TheWisator/RPII_DC_ePump/Submission/04_Drawings/01_Motor/Winding Layout.docx

## Winding Layout – Electric Motor RPII Pumps

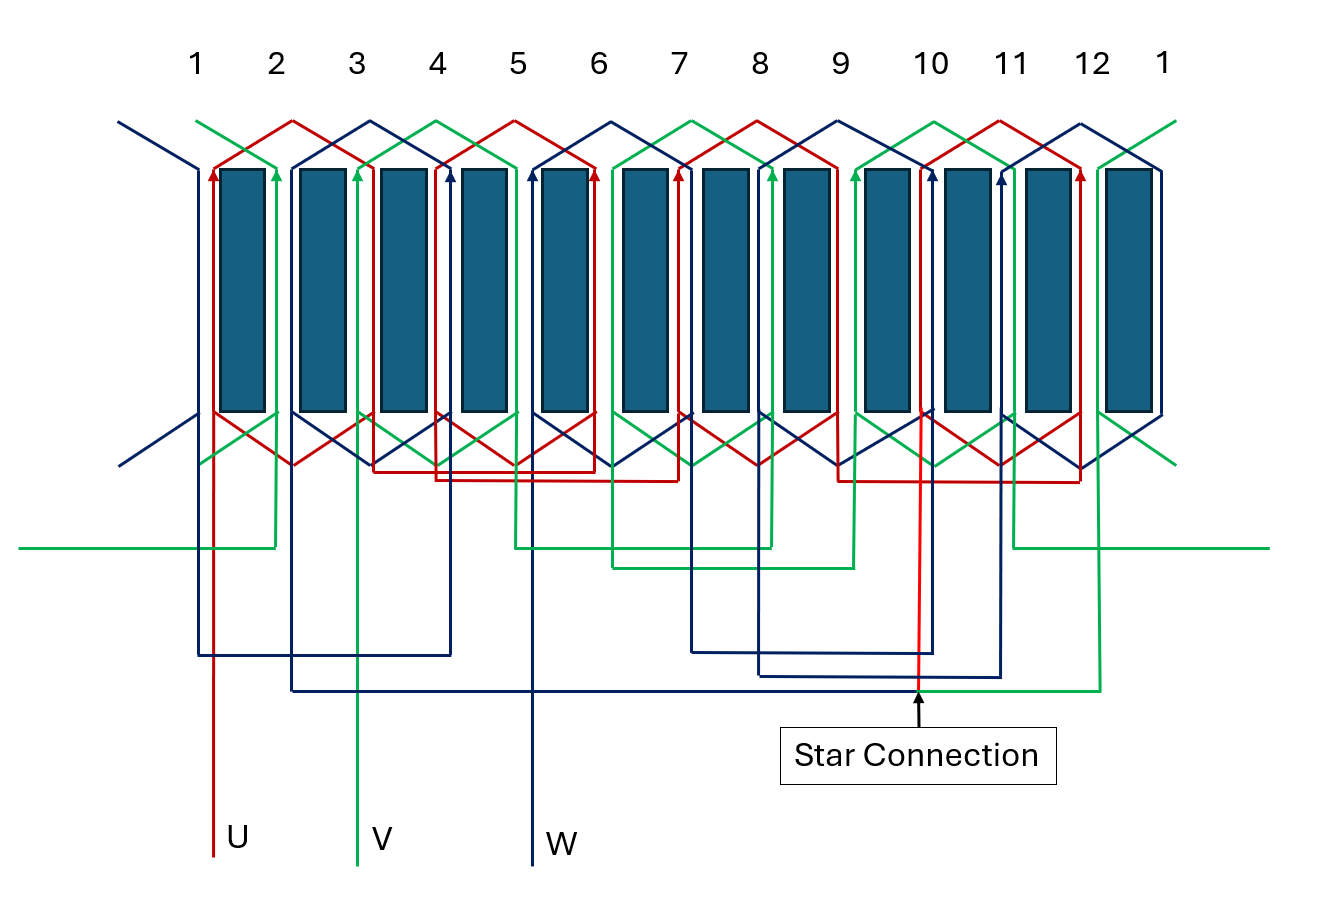
[picture p1: figure]

Winding parameters

Parameter | Value
Slots | 12
Phases | 3
Turns per Coil | 3
Wires at Hand | 14
Wire diameter (IEC-60317-13) [mm] | 0.75
Coil pitch | 2
Layers | 2
Parallel paths | 1
