TheWisator/RPII_DC_ePump/Submission/01_Skripts/02_Motor/FEM Studies/EM/T_over_n.pdf

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

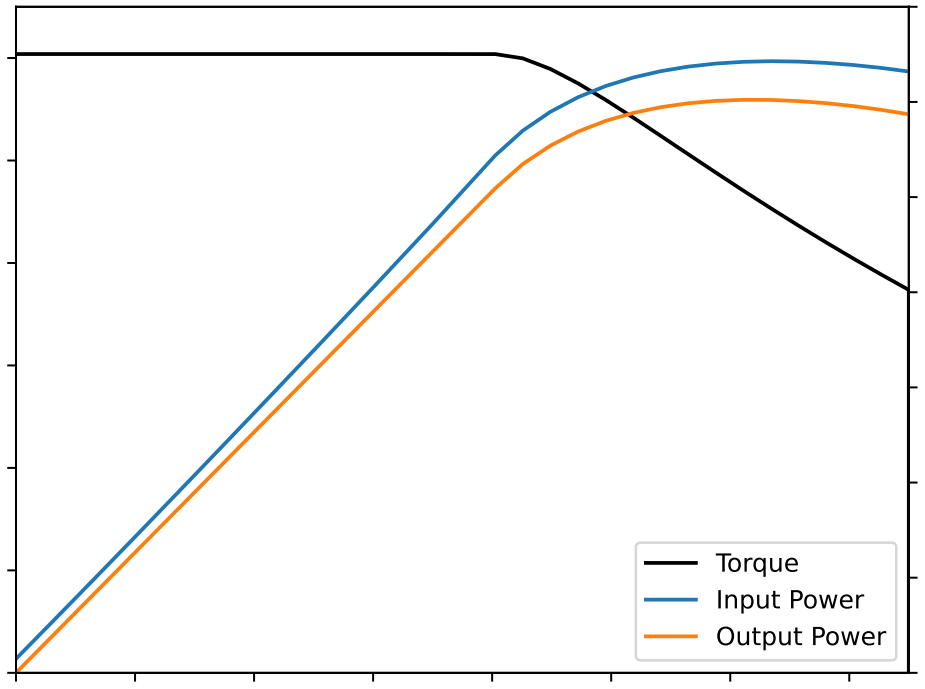
[picture p2: figure]
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
