TheWisator/RPII_DC_ePump/Submission/01_Skripts/02_Motor/FEM Studies/Structural/PEEK-30bar-0_3mm_pretension.png

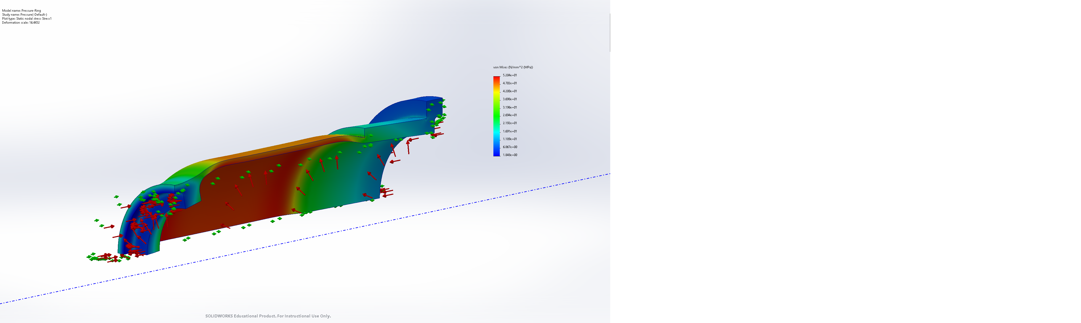
Submission/01_Skripts/02_Motor/FEM Studies/Structural/PEEK-30bar-0_3mm_pretension.png
