TheWisator/RPII_DC_ePump/Submission/02_CAD/Main-Housing.SLDPRT

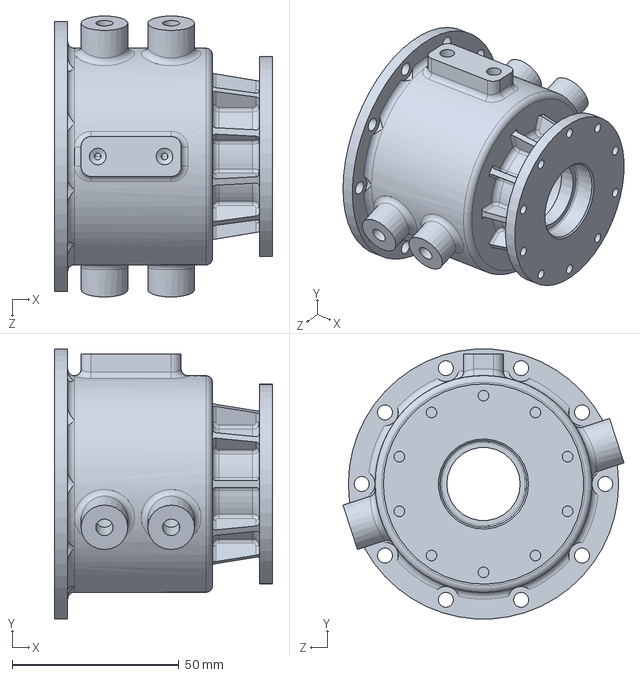
[picture p4: CAD file, 2024-03-20]
Submission/02_CAD/Main-Housing.SLDPRT
65.4 x 80.8 x 84.2 mm
