TheWisator/RPII_DC_ePump/Submission/02_CAD/MotorAssy_v1.SLDASM

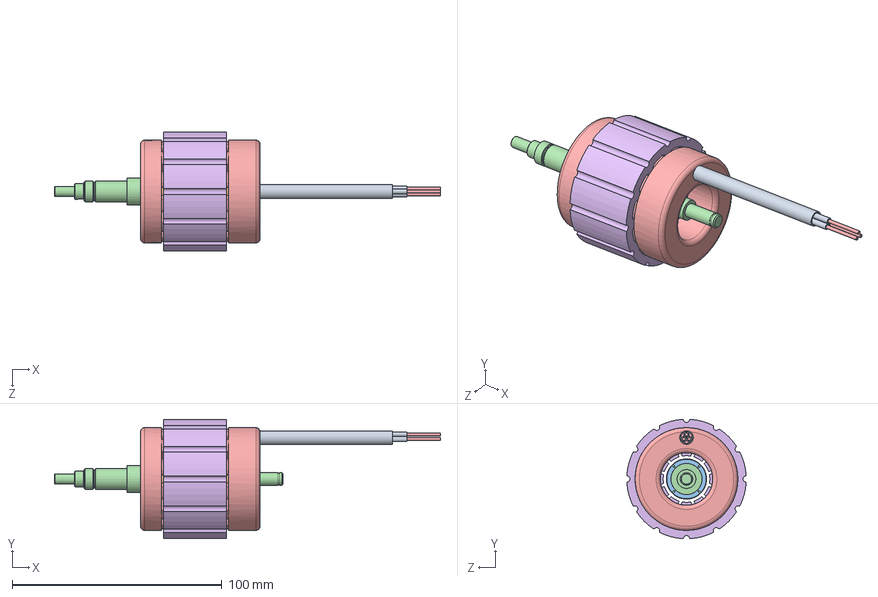
[picture p5: CAD file, 2024-03-20]
Submission/02_CAD/MotorAssy_v1.SLDASM
184.0 x 56.9 x 56.9 mm
Stator
Wind_Test_v1
Shaft
Permanent_Magnet_Arc x 4
CFRP-Rotor-Sleeve
Cable-Isolation
