TheWisator/RPII_DC_ePump/Submission/02_CAD/CI20-239-C-Ring.SLDPRT

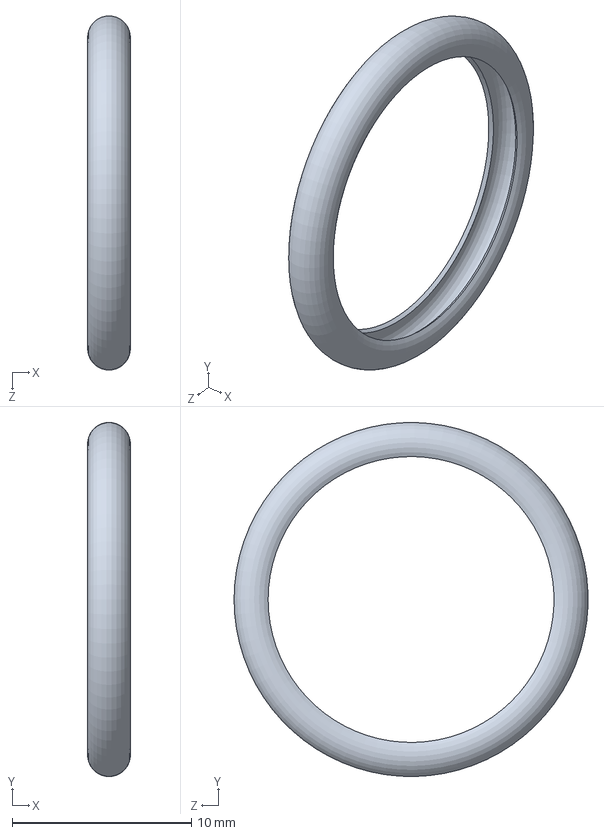
[picture p6: CAD file, 2024-03-20]
Submission/02_CAD/CI20-239-C-Ring.SLDPRT
2.39 x 19.7 x 19.7 mm
