TheWisator/RPII_DC_ePump/Submission/02_CAD/12x21x5-Ang_Hybrid_Ball_Bearing.SLDPRT

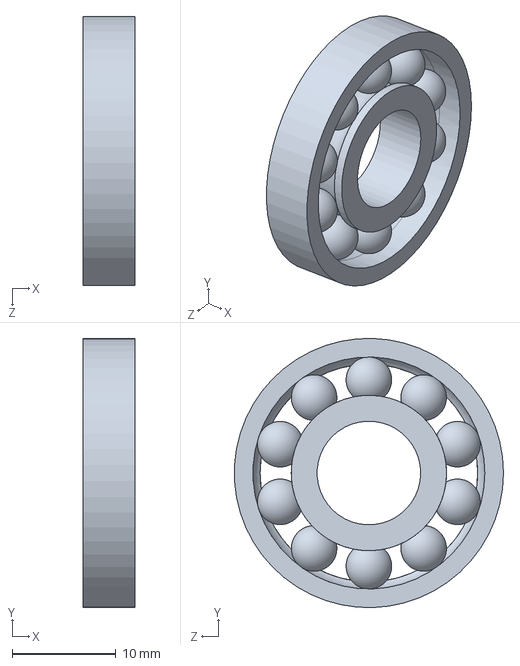
[picture p7: CAD file, 2024-03-20]
Submission/02_CAD/12x21x5-Ang_Hybrid_Ball_Bearing.SLDPRT
5.00 x 26.0 x 26.0 mm
