TheWisator/RPII_DC_ePump/Submission/02_CAD/Housing-Lid.SLDPRT

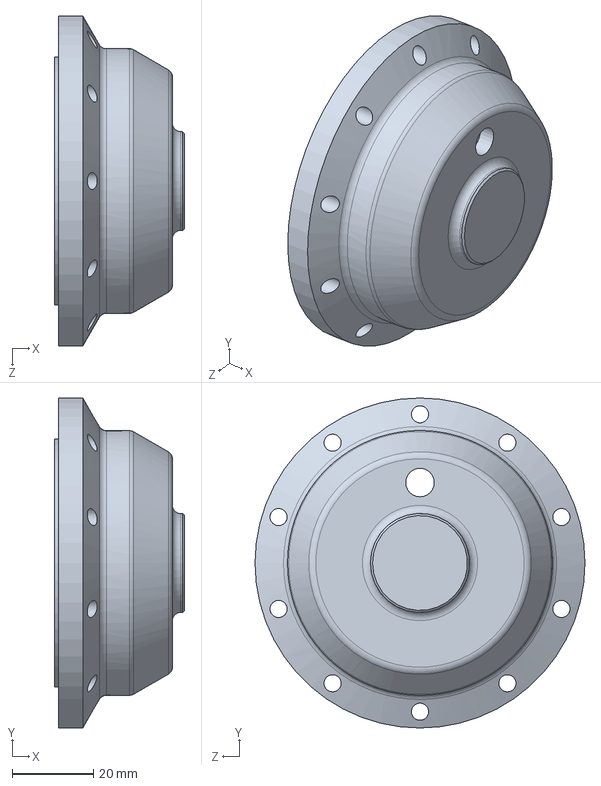
[picture p8: CAD file, 2024-03-20]
Submission/02_CAD/Housing-Lid.SLDPRT
32.0 x 81.0 x 81.0 mm
