TheWisator/RPII_DC_ePump/Submission/02_CAD/Rotor_Test_v1.SLDPRT

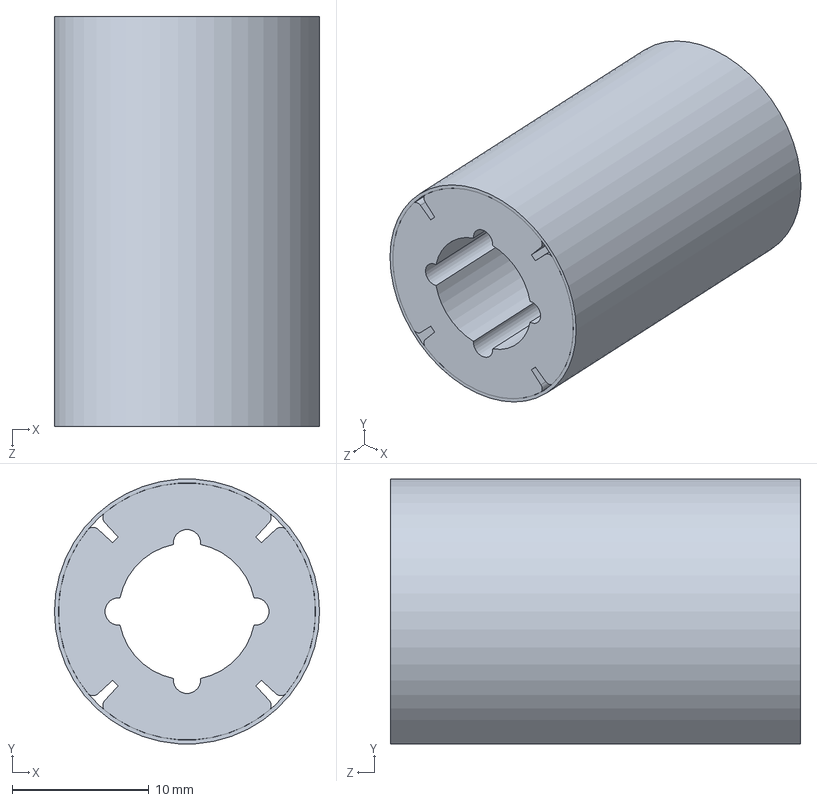
[picture p9: CAD file, 2024-03-20]
Submission/02_CAD/Rotor_Test_v1.SLDPRT
19.4 x 19.4 x 30.0 mm
