TheWisator/RPII_DC_ePump/Submission/02_CAD/Permanent_Magnet_Arc.SLDPRT

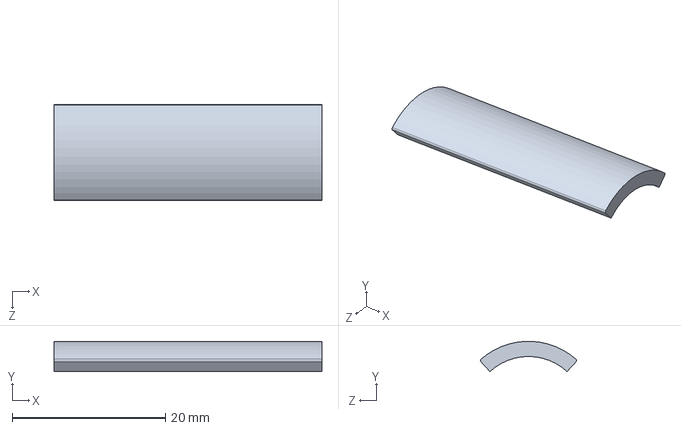
[picture p10: CAD file, 2024-03-20]
Submission/02_CAD/Permanent_Magnet_Arc.SLDPRT
35.0 x 3.94 x 12.5 mm
