TheWisator/RPII_DC_ePump/Submission/02_CAD/7x14x5-Hybrid_Ball_Bearing.SLDPRT

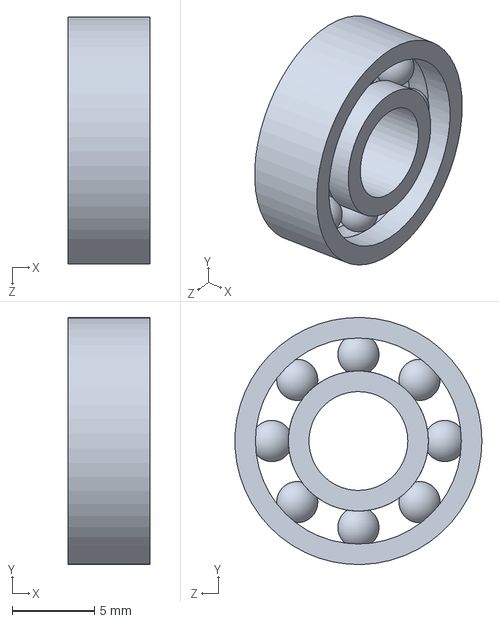
[picture p11: CAD file, 2024-03-20]
Submission/02_CAD/7x14x5-Hybrid_Ball_Bearing.SLDPRT
5.00 x 15.0 x 15.0 mm
