TheWisator/RPII_DC_ePump/Submission/02_CAD/Bearing-Ring.SLDPRT

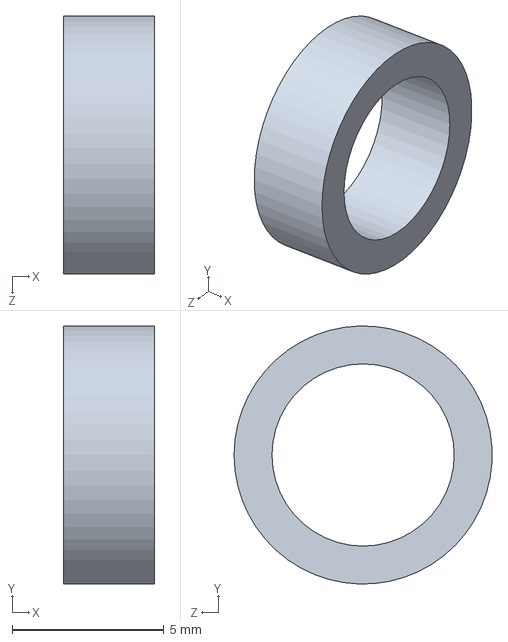
[picture p12: CAD file, 2024-03-20]
Submission/02_CAD/Bearing-Ring.SLDPRT
3.00 x 8.50 x 8.49 mm
