TheWisator/RPII_DC_ePump/Submission/02_CAD/CFRP-Rotor-Sleeve.SLDPRT

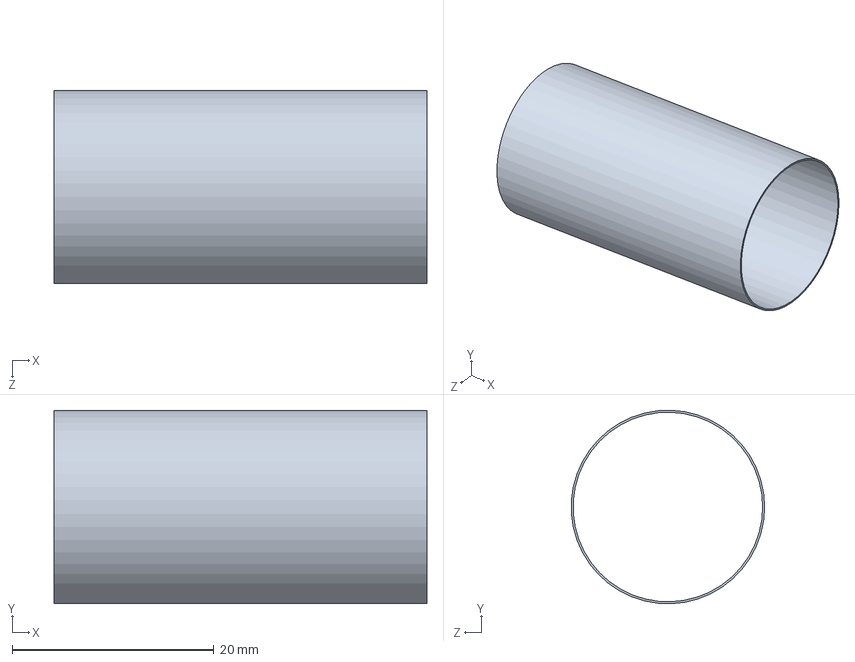
[picture p13: CAD file, 2024-03-20]
Submission/02_CAD/CFRP-Rotor-Sleeve.SLDPRT
37.0 x 19.2 x 19.2 mm
