TheWisator/RPII_DC_ePump/Submission/02_CAD/Impeller_LOX.SLDPRT

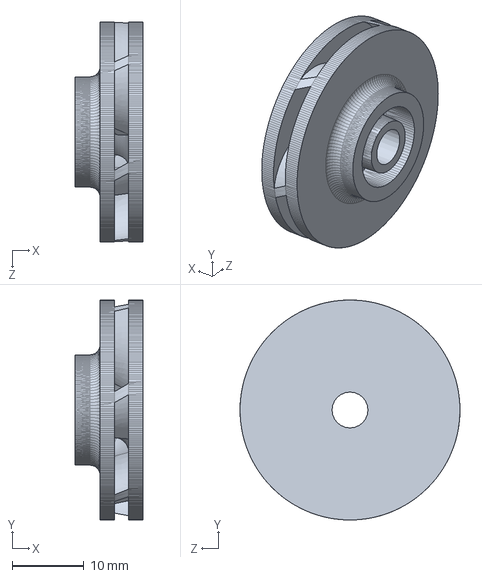
[picture p14: CAD file, 2024-03-20]
Submission/02_CAD/Impeller_LOX.SLDPRT
9.50 x 30.7 x 30.7 mm
