TheWisator/RPII_DC_ePump/Submission/02_CAD/Pressure-Ring.SLDPRT

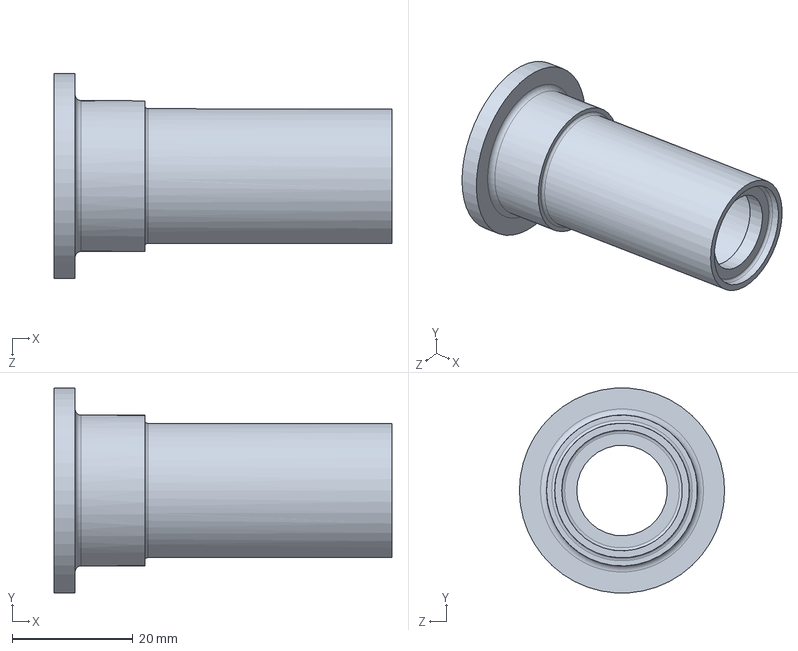
[picture p15: CAD file, 2024-03-20]
Submission/02_CAD/Pressure-Ring.SLDPRT
56.0 x 33.9 x 34.0 mm
