TheWisator/RPII_DC_ePump/Submission/02_CAD/RPDC_Diffuser_Pump_Volute_Casing_LOX.SLDPRT

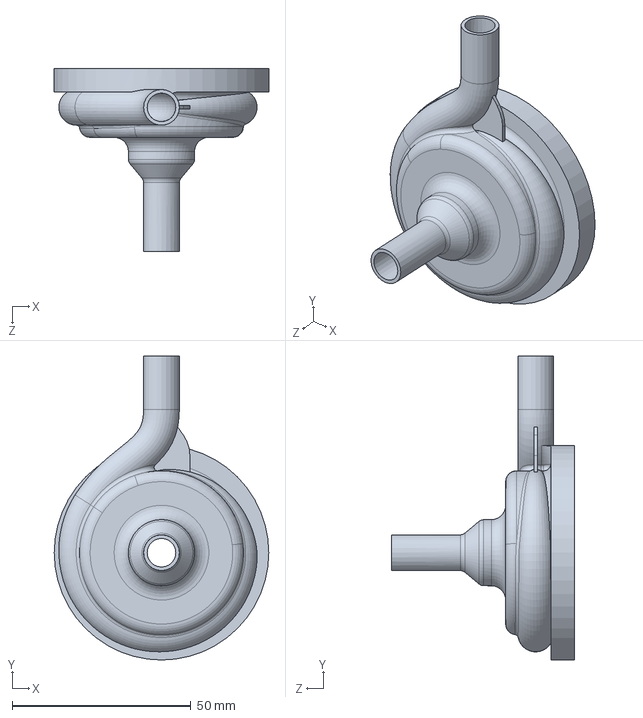
[picture p16: CAD file, 2024-03-20]
Submission/02_CAD/RPDC_Diffuser_Pump_Volute_Casing_LOX.SLDPRT
60.0 x 85.0 x 51.2 mm
