TheWisator/RPII_DC_ePump/Submission/02_CAD/CI25-239-C-Ring.SLDPRT

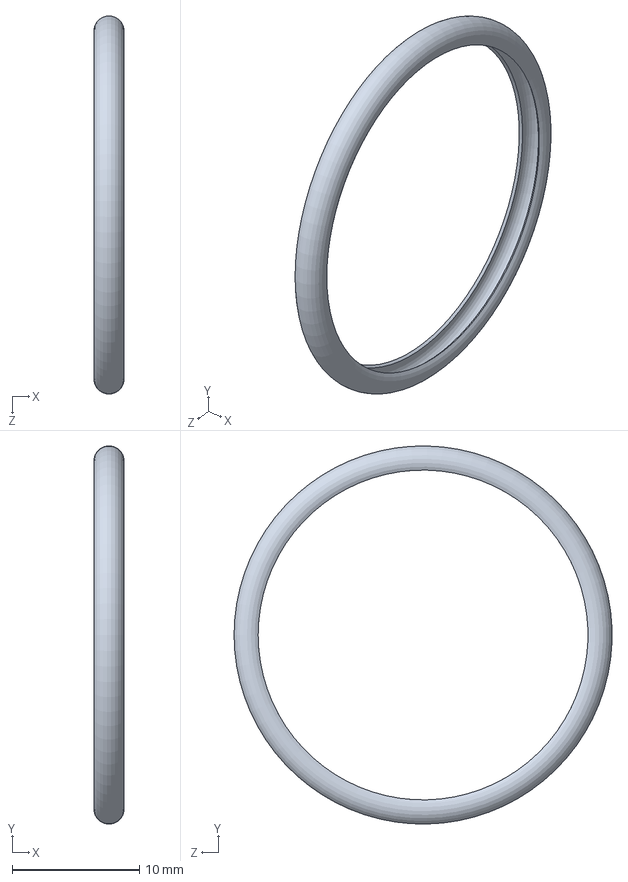
[picture p17: CAD file, 2024-03-20]
Submission/02_CAD/CI25-239-C-Ring.SLDPRT
2.37 x 29.7 x 29.7 mm
