TheWisator/RPII_DC_ePump/Submission/02_CAD/Diffuser_LOX.SLDPRT

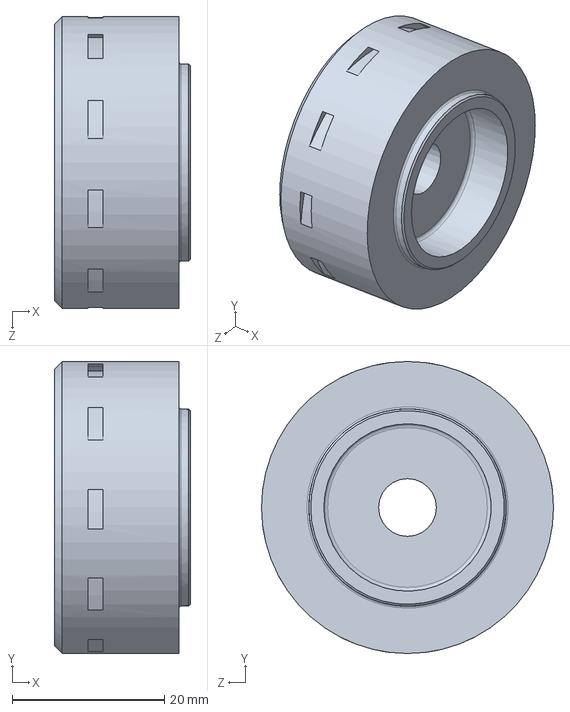
[picture p18: CAD file, 2024-03-20]
Submission/02_CAD/Diffuser_LOX.SLDPRT
17.9 x 38.4 x 38.4 mm
