TheWisator/RPII_DC_ePump/Submission/02_CAD/Tension-Ring.SLDPRT

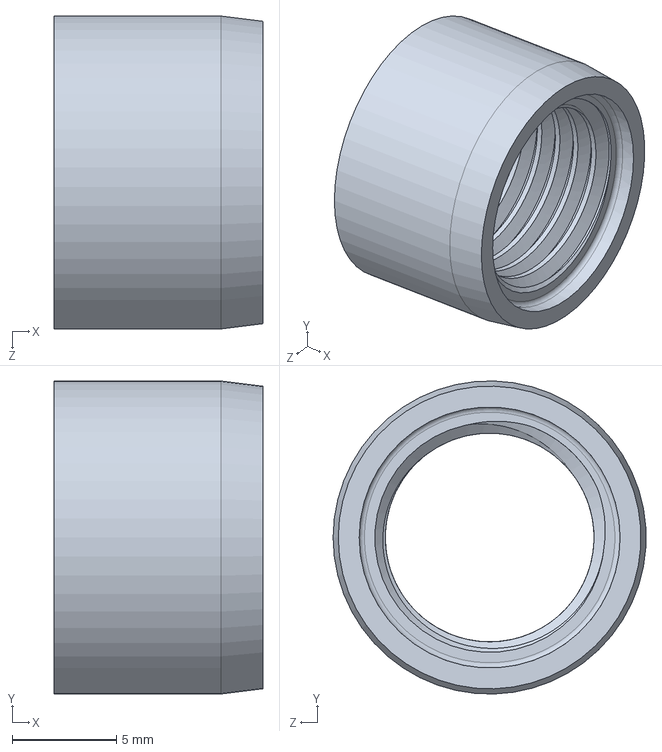
[picture p19: CAD file, 2024-03-20]
Submission/02_CAD/Tension-Ring.SLDPRT
10.0 x 15.0 x 15.0 mm
