TheWisator/RPII_DC_ePump/Submission/02_CAD/Stat_Test_v1.SLDPRT

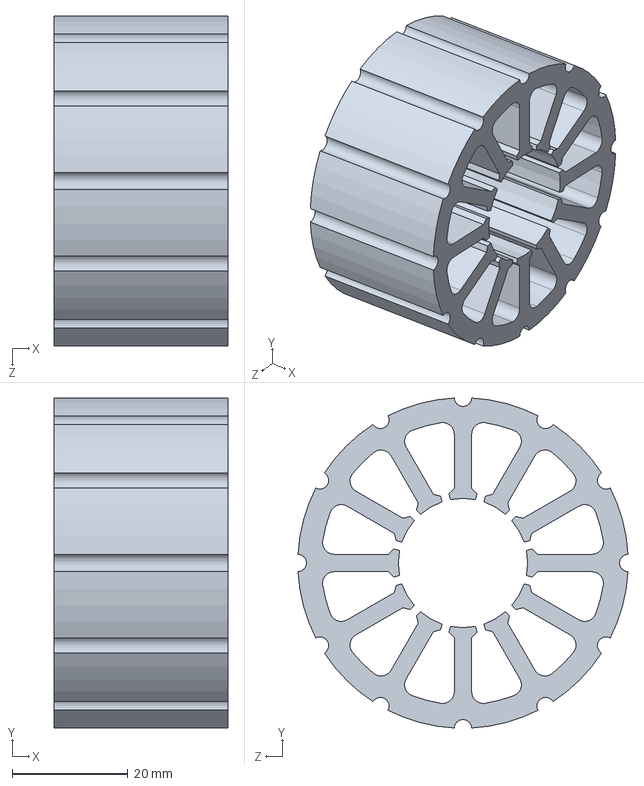
[picture p20: CAD file, 2024-03-20]
Submission/02_CAD/Stat_Test_v1.SLDPRT
30.0 x 56.9 x 56.9 mm
