TheWisator/RPII_DC_ePump/Submission/02_CAD/Wind_Test_v1.SLDPRT

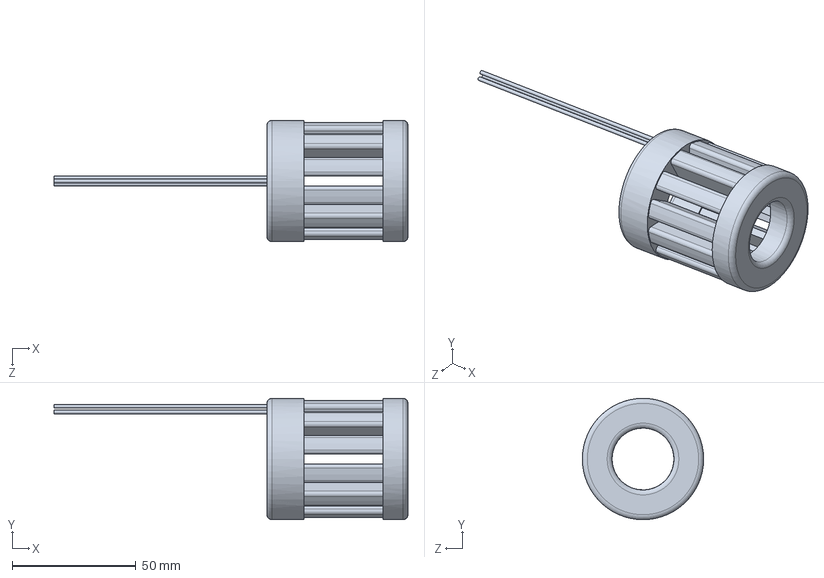
[picture p21: CAD file, 2024-03-20]
Submission/02_CAD/Wind_Test_v1.SLDPRT
143.0 x 49.0 x 49.0 mm
