TheWisator/RPII_DC_ePump/Submission/02_CAD/Shaft.SLDPRT

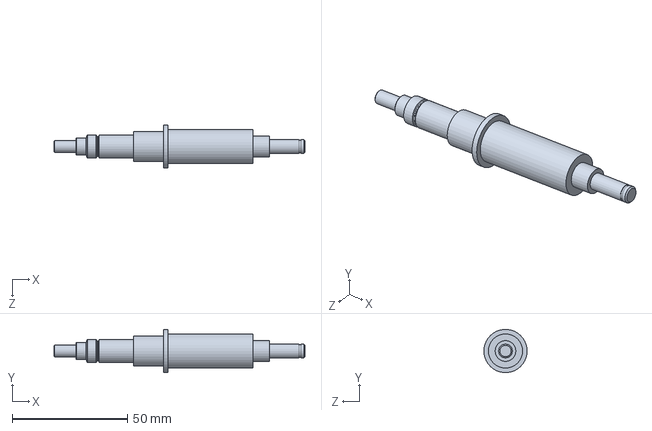
[picture p22: CAD file, 2024-03-20]
Submission/02_CAD/Shaft.SLDPRT
109.0 x 18.7 x 18.8 mm
