TheWisator/RPII_DC_ePump/Submission/02_CAD/Stator_Test_v1.SLDPRT

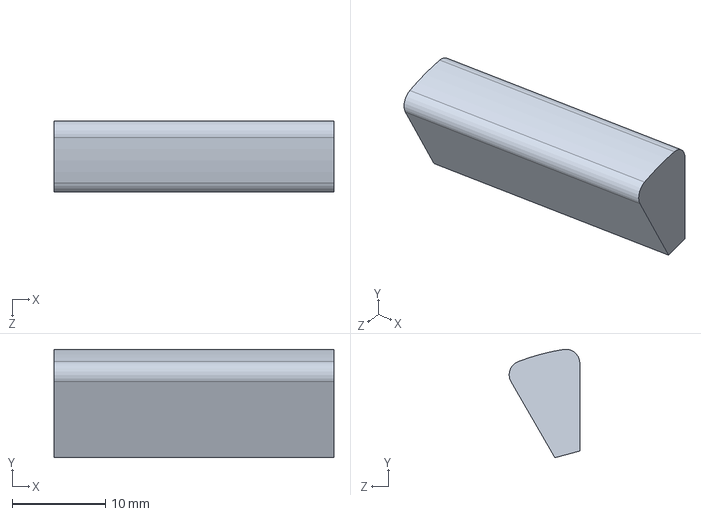
[picture p23: CAD file, 2024-03-20]
Submission/02_CAD/Stator_Test_v1.SLDPRT
30.0 x 11.6 x 7.58 mm
