TheWisator/RPII_DC_ePump/Submission/02_CAD/Controller_HBCi10063.STEP

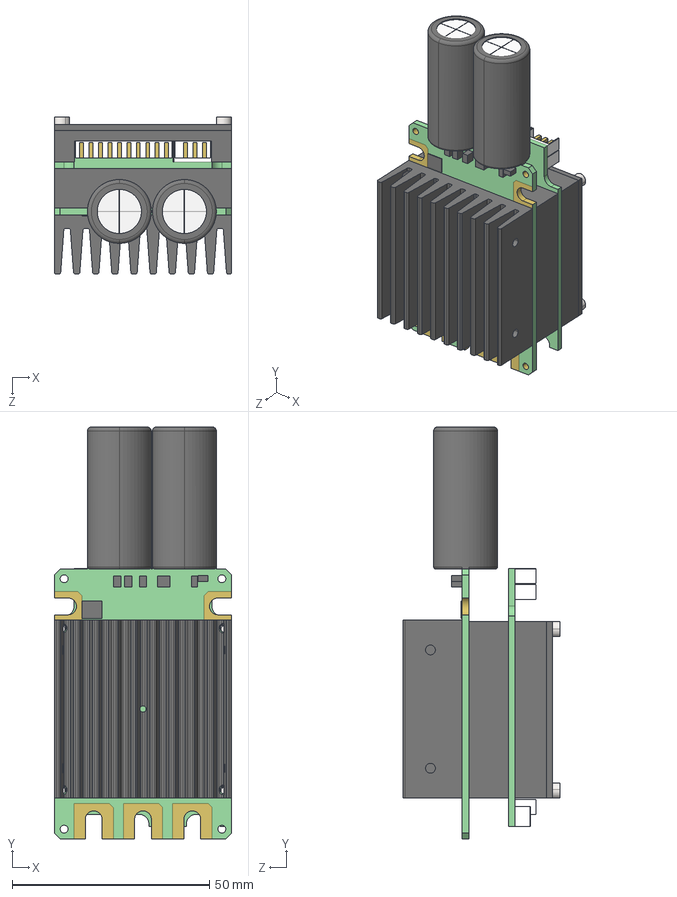
[picture p24: CAD file, 2024-03-20]
Submission/02_CAD/Controller_HBCi10063.STEP
45.0 x 104.5 x 39.9 mm
main_board
Cover_buttom
Cover_top
Top cover
Cooler
Control_board
ISO 4762 M2 x 20 - 20N_ISO 4762 M2 x 20 - 20N x 4
