TheWisator/RPII_DC_ePump/Submission/02_CAD/Cable-Isolation.SLDPRT

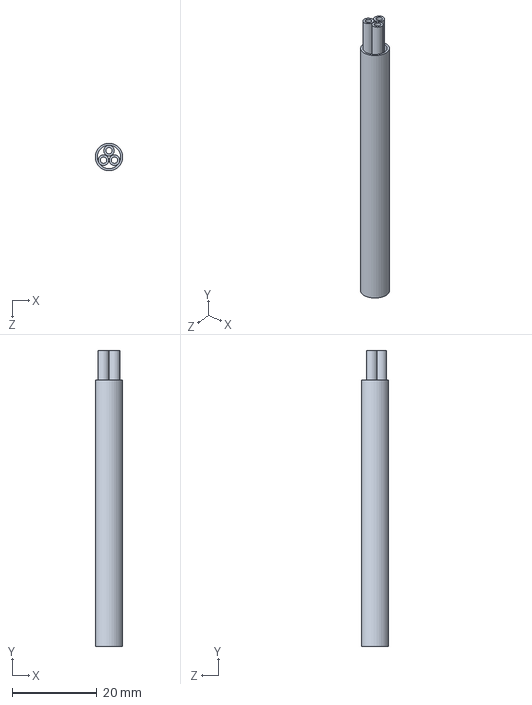
[picture p25: CAD file, 2024-03-20]
Submission/02_CAD/Cable-Isolation.SLDPRT
6.47 x 70.0 x 6.50 mm
