TheWisator/RPII_DC_ePump/Submission/02_CAD/Cooling-Adapter.SLDPRT

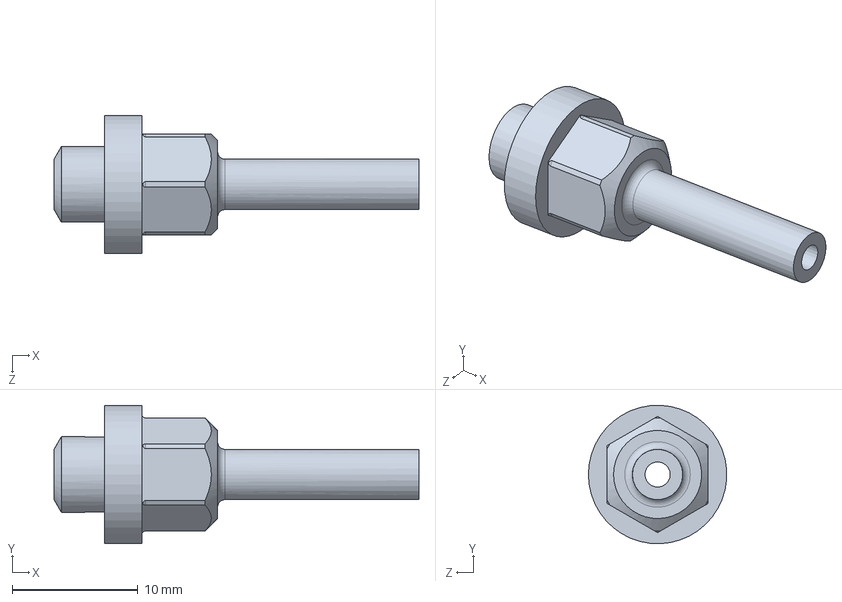
[picture p26: CAD file, 2024-03-20]
Submission/02_CAD/Cooling-Adapter.SLDPRT
29.0 x 11.0 x 11.0 mm
