TheWisator/RPII_DC_ePump/Submission/02_CAD/Battery.stp

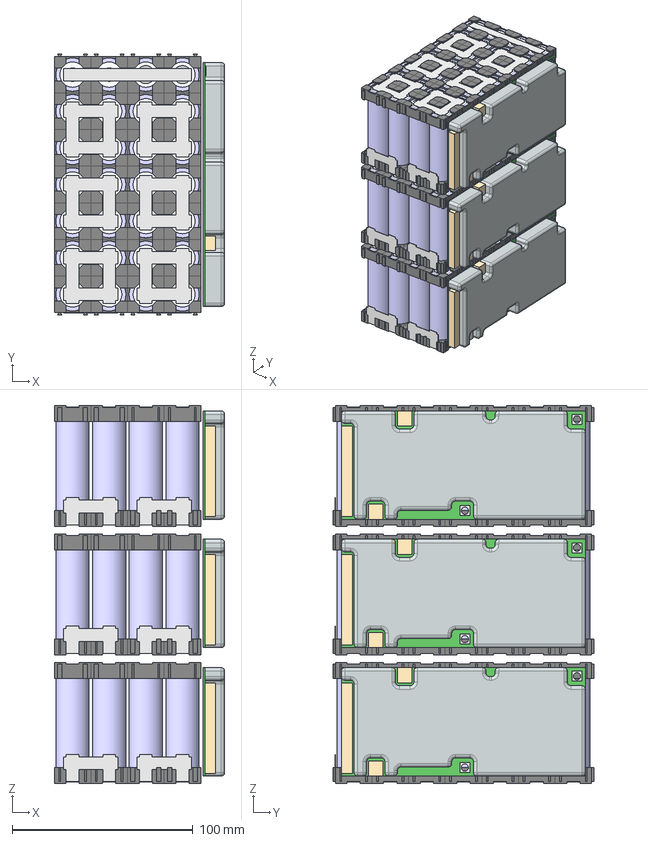
[picture p27: CAD file, 2024-03-20]
Submission/02_CAD/Battery.stp
94.3 x 144.3 x 209.0 mm
spacer x 336
BMS x 3
nickel-grid x 36
nickel-strip-long x 3
nickel-grid-half x 12
