TheWisator/RPII_DC_ePump/Submission/02_CAD/Shaft-Model-Reduced.SLDASM

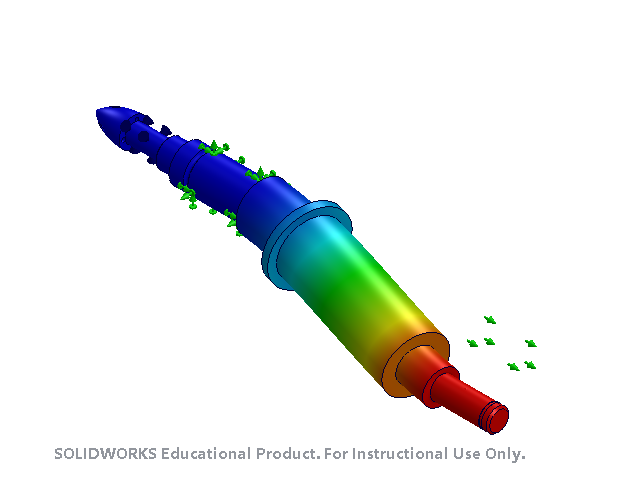
[picture p28: CAD file, 2024-03-20]
Submission/02_CAD/Shaft-Model-Reduced.SLDASM
Impeller-Nut
Shaft
