TheWisator/RPII_DC_ePump/(list of files, cad)

Other CAD files:
Submission/02_CAD/Stator.SLDPRT
Submission/02_CAD/65363000-KM 0-M10 x 0_75.stp
Submission/02_CAD/65399530-MB 0.stp
Submission/02_CAD/Controller_HBCi10063.SLDPRT
Submission/02_CAD/DIN933-M3.SLDPRT
Submission/02_CAD/Housing-Lid.SLDDRW
Submission/02_CAD/Impeller-Nut.SLDPRT
Submission/02_CAD/Main-Housing.SLDDRW
Submission/02_CAD/MotorAssy_v1.SLDDRW
Submission/02_CAD/Permanent_Magnet_Arc.SLDDRW
Submission/02_CAD/Pressure-Ring.SLDDRW
Submission/02_CAD/Shaft.SLDDRW
Submission/02_CAD/Stator.SLDDRW
