TheWisator/RPII_DC_ePump/Submission/01_Skripts/02_Motor/FEM Studies/EM/Optim_Results_1.csv

OD | L | TM | HS | WT | WIN | Mass | MR | MS | TRQ | P | EFF | VOL
55 | 30 | 1.5 | 12.5 | 3 | 10 | 0.6473972 | 0.0494029 | 0.5979943 | 0.5203448 | 2179.6153 | 93.3983 | 39.102341
60.272 | 33.976 | 1.9840001 | 11.746876 | 3.27421 | 8 | 0.7874552 | 0.0556832 | 0.7317721 | 0.5246581 | 2197.6826 | 94.966658 | 45.374363
51.9272 | 34.8976 | 1.1984 | 13.774428 | 3.3673511 | 8 | 0.5611984 | 0.0576477 | 0.5035507 | 0.3166259 | 1326.2796 | 81.56722 | 33.170415
59.6032 | 34.7056 | 1.0704 | 13.728264 | 3.4767476 | 10 | 0.8124774 | 0.0574082 | 0.7550692 | 0.5198549 | 2177.5629 | 94.085553 | 41.35781
60.3784 | 28.5872 | 1.9248 | 12.997873 | 2.7388399 | 8 | 0.6538836 | 0.0468783 | 0.6070054 | 0.4330382 | 1813.9063 | 93.636943 | 38.178795
53.1736 | 34.6288 | 1.2192 | 11.307465 | 3.4865587 | 11 | 0.6444199 | 0.0484391 | 0.5959808 | 0.3573352 | 1496.8023 | 92.800865 | 35.312147
52.2768 | 34.3344 | 1.2896 | 11.033568 | 2.8099586 | 8 | 0.6085147 | 0.0566632 | 0.5518515 | 0.446309 | 1869.4946 | 93.4249 | 40.350915
60.4848 | 31.1984 | 1.8656001 | 11.252327 | 3.4090106 | 11 | 0.6484457 | 0.0559315 | 0.5925142 | 0.4161319 | 1743.0894 | 94.136478 | 38.348796
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
