TheWisator/RPII_DC_ePump/Submission/04_Drawings/01_Motor/Motor-Assembly.pdf

E E

F F

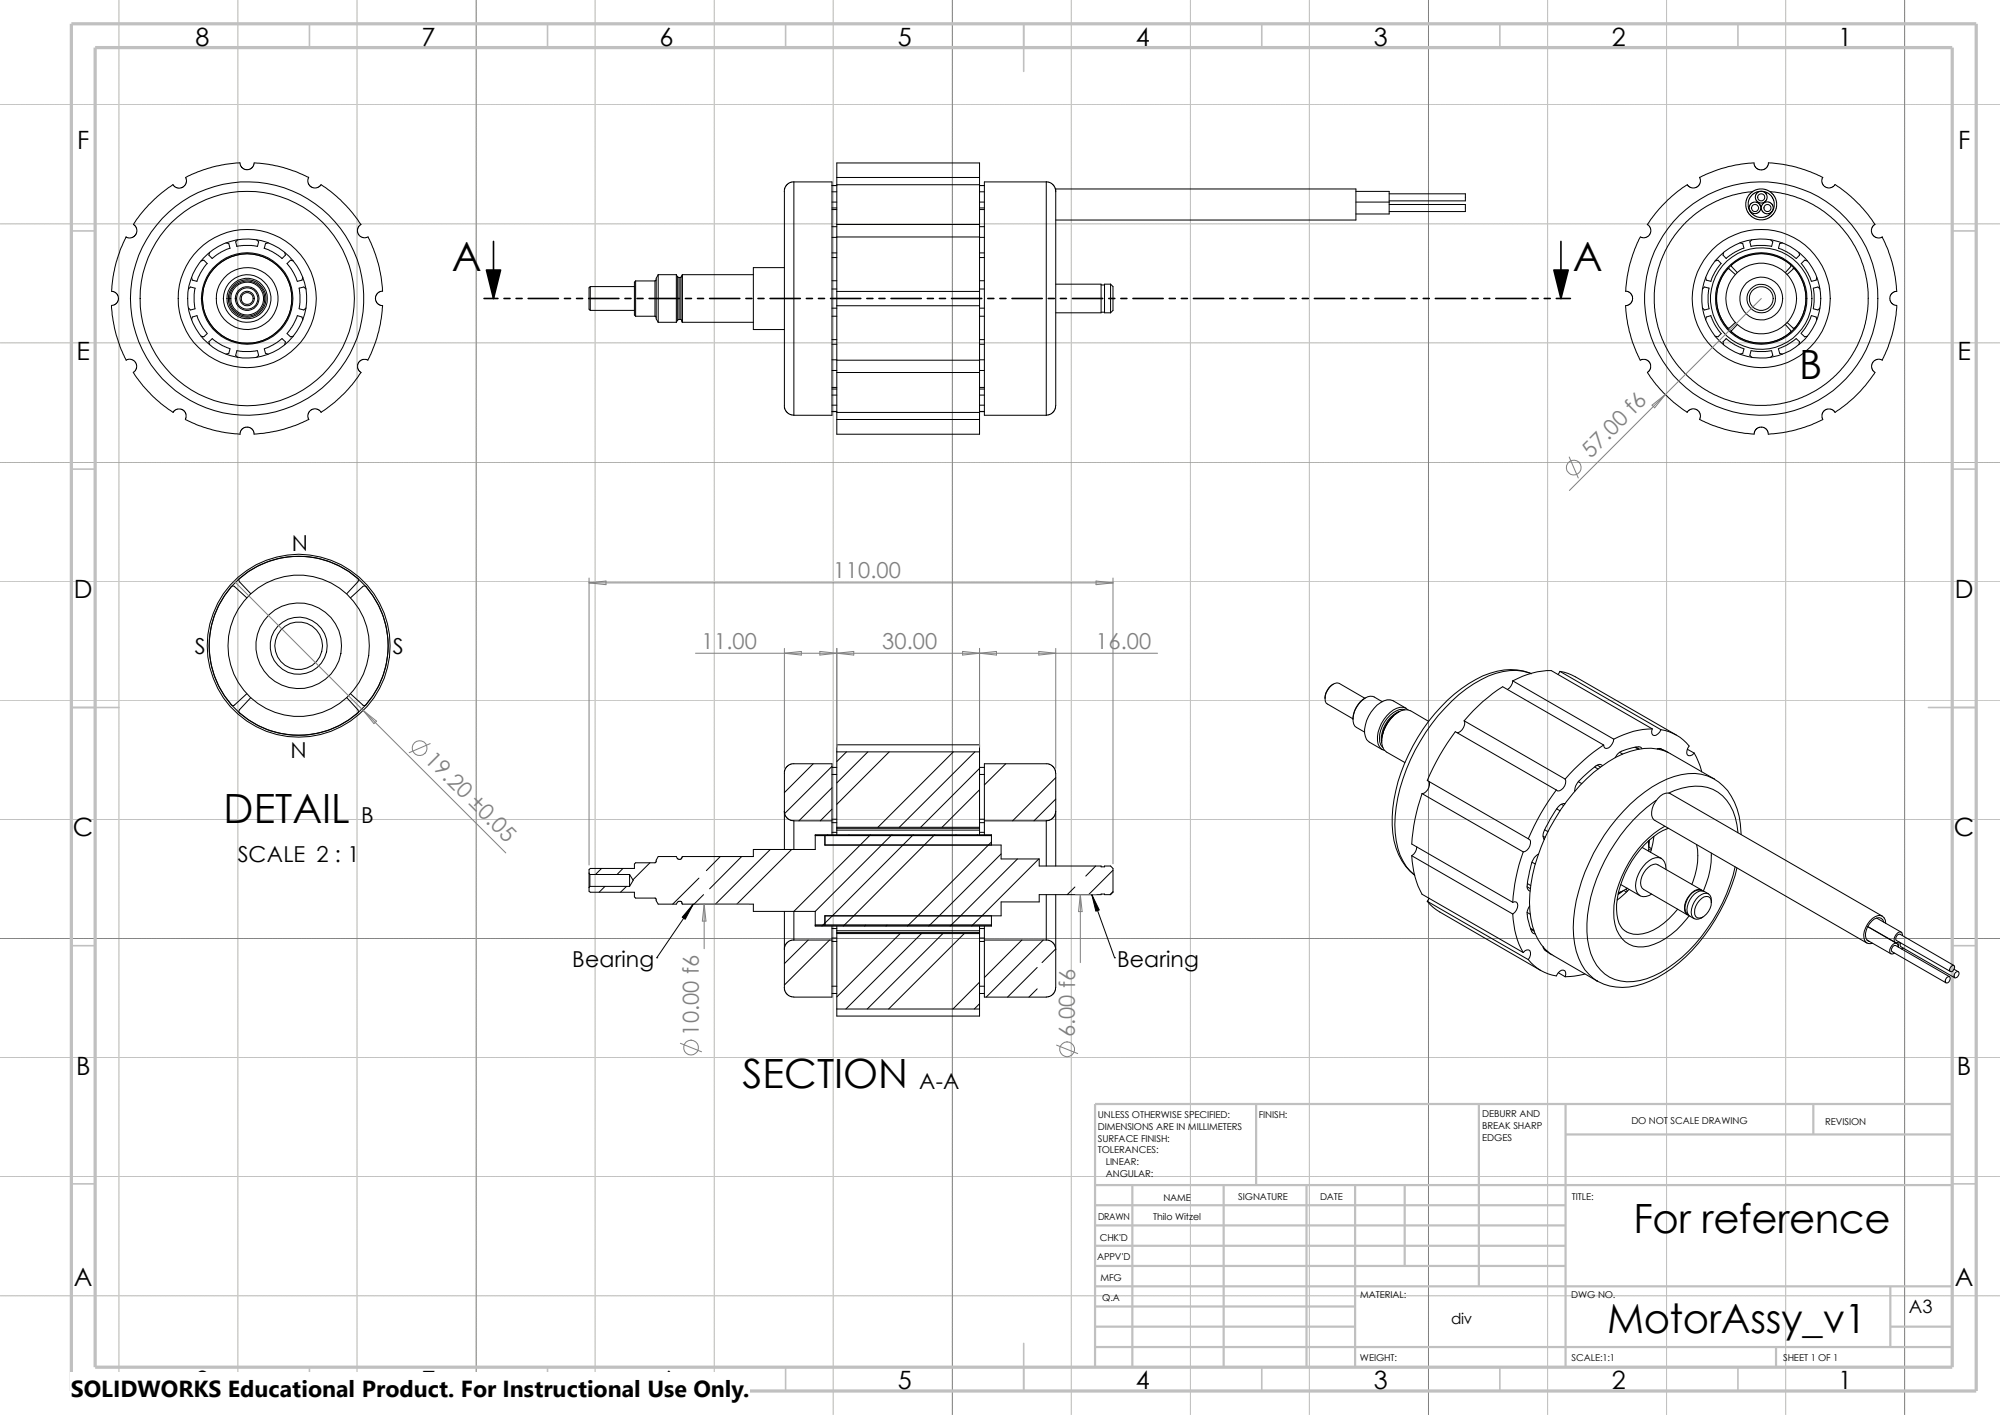
[picture p29: page 1]
FINISH:; EDGES; DO NOT SCALE DRAWING; REVISION; DEBURR AND BREAK SHARP; N DETAIL B; SCALE; SECTION A-A; Bearing

UNLESS OTHERWISE SPECIFIED:
DIMENSIONS ARE IN MILLIMETERS
SURFACE FINISH:
TOLERANCES:
LINEAR:
ANGULAR:

NAME | SIGNATURE | DATE | | | | TITLE: For reference

DRAWN | Thilo Witzel
CHK'D
APPV'D
Q.A | | | | MATERIAL: | div | DWG NO. MotorAssy_v1 | | A3

MFG

WEIGHT: | | SCALE:1:1 | | SHEET 1 OF 1

SOLIDWORKS Educational Product. For Instructional Use Only.
