TheWisator/RPII_DC_ePump/Submission/04_Drawings/LOX_Pump_Drawing.pdf

E E

F F

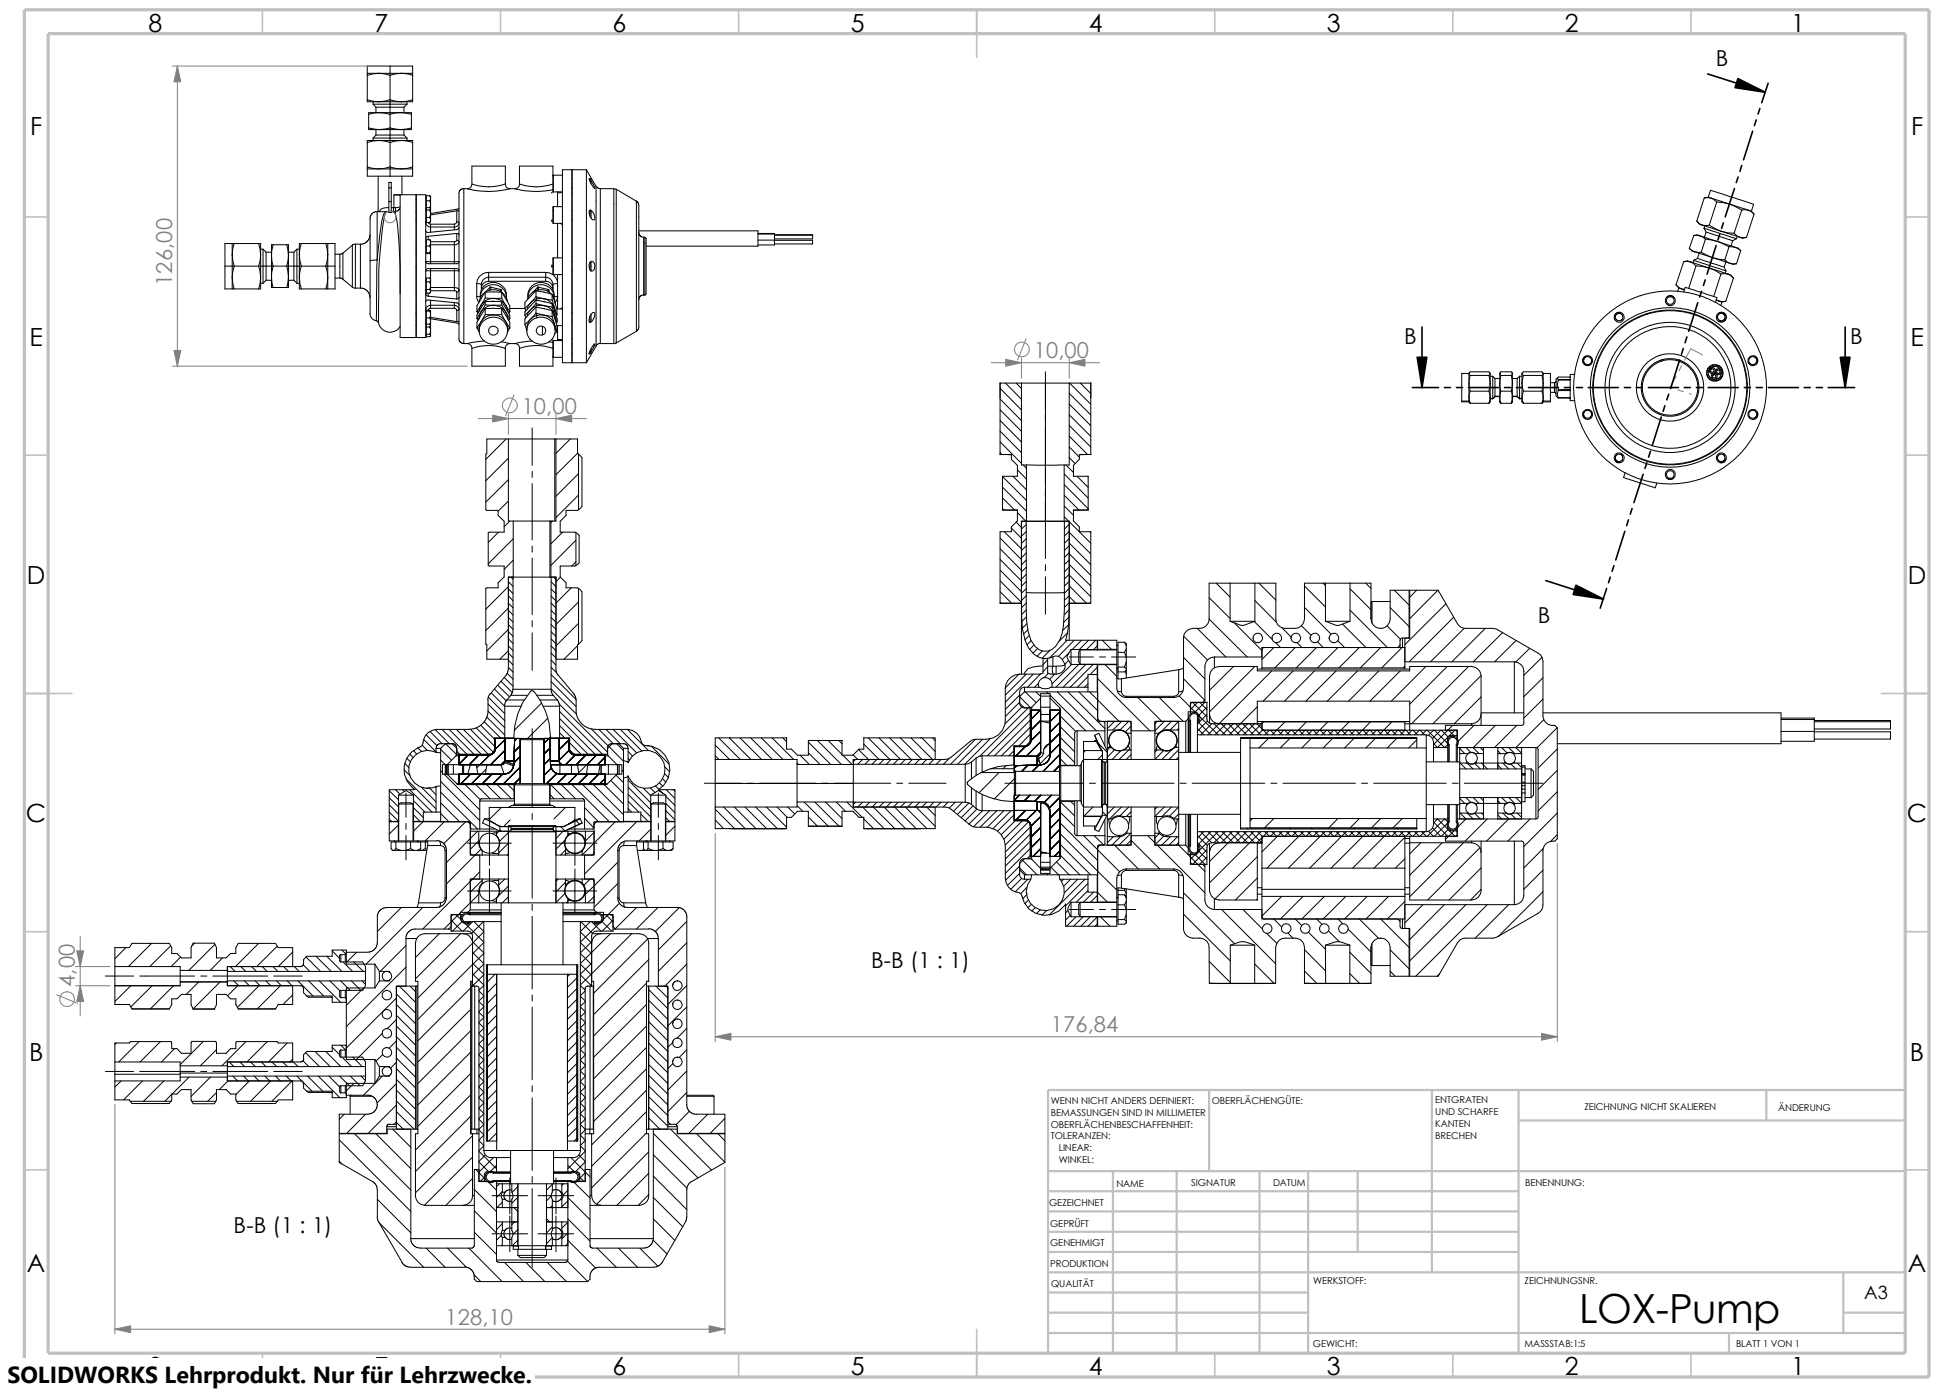
[picture p30: page 1]
GEWICHT:; MASSSTAB:1:5; BLATT 1 VON 1; BENENNUNG:; ZEICHNUNG NICHT SKALIEREN; ÄNDERUNG; DATUM; OBERFLÄCHENGÜTE:; KANTEN; UND SCHARFE; NAME; ENTGRATEN; SIGNATUR; BRECHEN; GEZEICHNET 126,00

WENN NICHT ANDERS DEFINIERT:
BEMASSUNGEN SIND IN MILLIMETER
OBERFLÄCHENBESCHAFFENHEIT:
TOLERANZEN:
LINEAR:
WINKEL:

GEPRÜFT
GENEHMIGT
QUALITÄT | WERKSTOFF: | ZEICHNUNGSNR. LOX-Pump | A3

PRODUKTION

SOLIDWORKS Lehrprodukt. Nur für Lehrzwecke.
