TheWisator/RPII_DC_ePump/Submission/04_Drawings/01_Motor/Stator.pdf

E E

F F

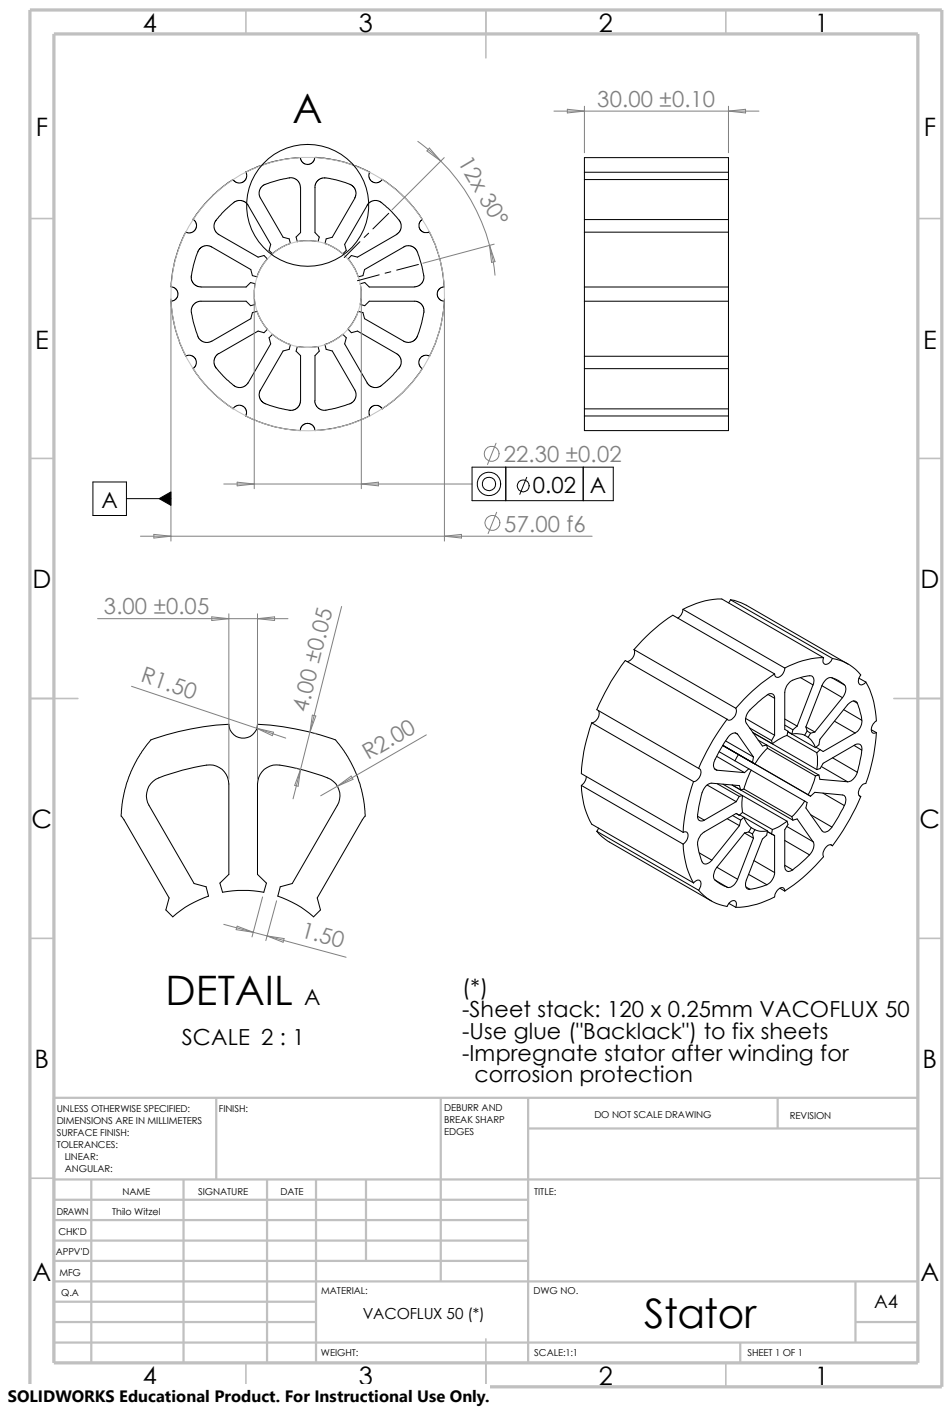
[picture p31: page 1]
VACOFLUX 50 (*); WEIGHT:; SCALE:1:1; SHEET 1 OF 1; DWG NO.; MFG; FINISH:; EDGES; MATERIAL:; DO NOT SCALE DRAWING; REVISION; DEBURR AND BREAK SHARP; Stator; DETAIL A; SCALE 2 : 1

-Sheet stack: 120 x 0.25mm VACOFLUX 50
-Use glue ("Backlack") to fix sheets
-Impregnate stator after winding for
corrosion protection

UNLESS OTHERWISE SPECIFIED:
DIMENSIONS ARE IN MILLIMETERS
SURFACE FINISH:
TOLERANCES:
LINEAR:
ANGULAR:

NAME | SIGNATURE | DATE | TITLE:

DRAWN | Thilo Witzel
CHK'D
APPV'D

SOLIDWORKS Educational Product. For Instructional Use Only.
