TheWisator/RPII_DC_ePump/Submission/04_Drawings/01_Motor/Magnet.pdf

E E

F F

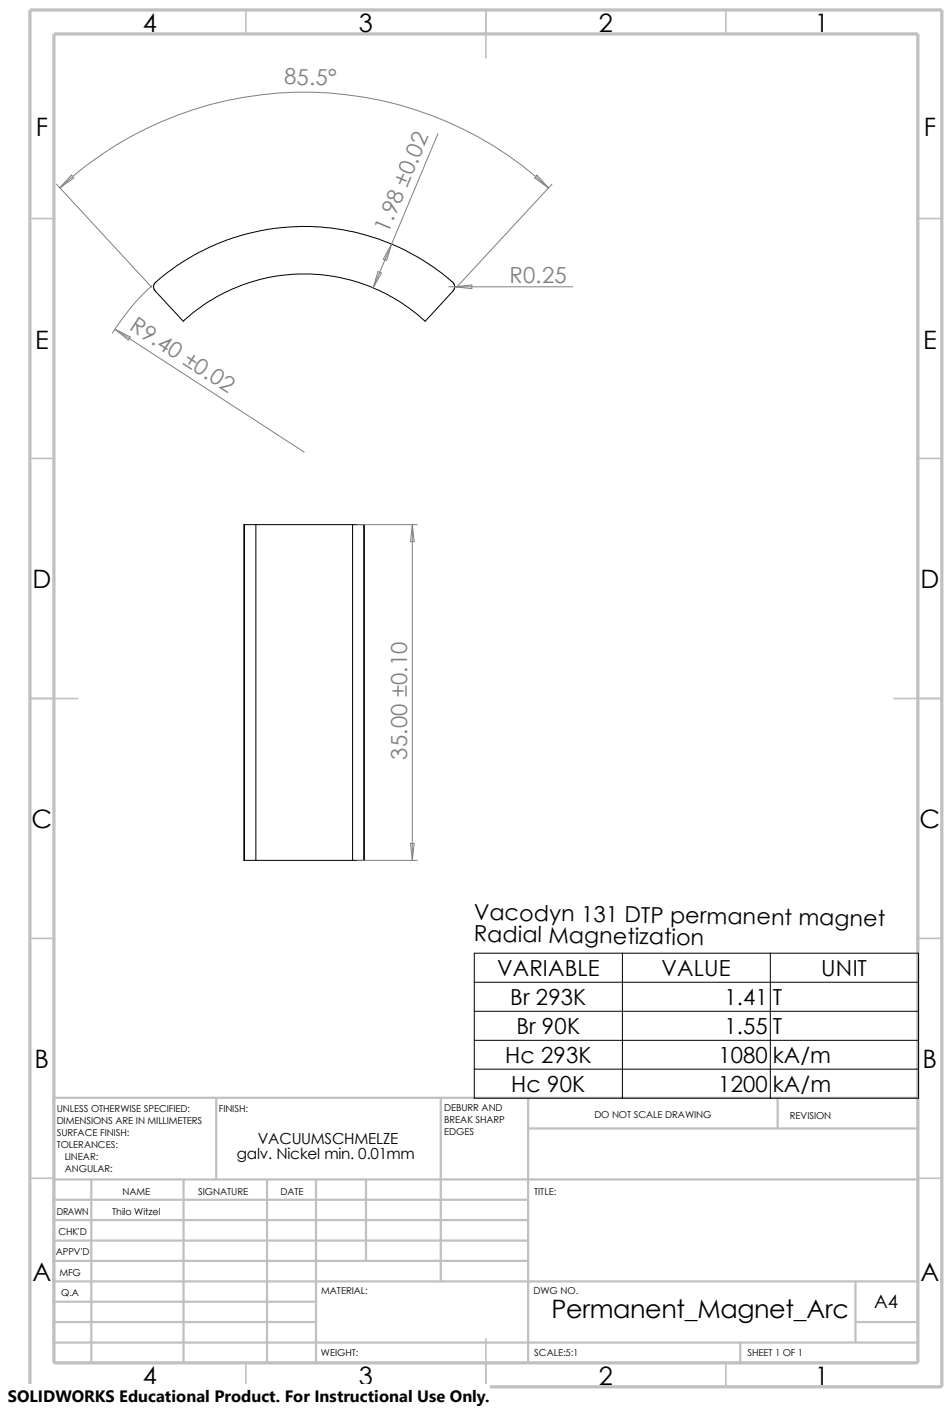
[picture p32: page 1]
SHEET 1 OF 1; WEIGHT:; SCALE:5:1; DWG NO.; MATERIAL:; MFG; Permanent_Magnet_Arc

Vacodyn 131 DTP permanent magnet Radial Magnetization 35.00 ±0.10

VARIABLE | VALUE | UNIT
Br 293K | 1.41 T
Br 90K | 1.55 T

UNLESS OTHERWISE SPECIFIED: DIMENSIONS ARE IN MILLIMETERS SURFACE FINISH: TOLERANCES: LINEAR: ANGULAR: | FINISH: VACUUMSCHMELZE galv. Nickel min. 0.01mm | DEBURR AND BREAK SHARP EDGES | DO NOT SCALE DRAWING | REVISION

NAME | SIGNATURE | DATE | TITLE:

DRAWN | Thilo Witzel
CHK'D
APPV'D

SOLIDWORKS Educational Product. For Instructional Use Only.
