TheWisator/RPII_DC_ePump/Submission/04_Drawings/01_Motor/Shaft.pdf

E E

F F

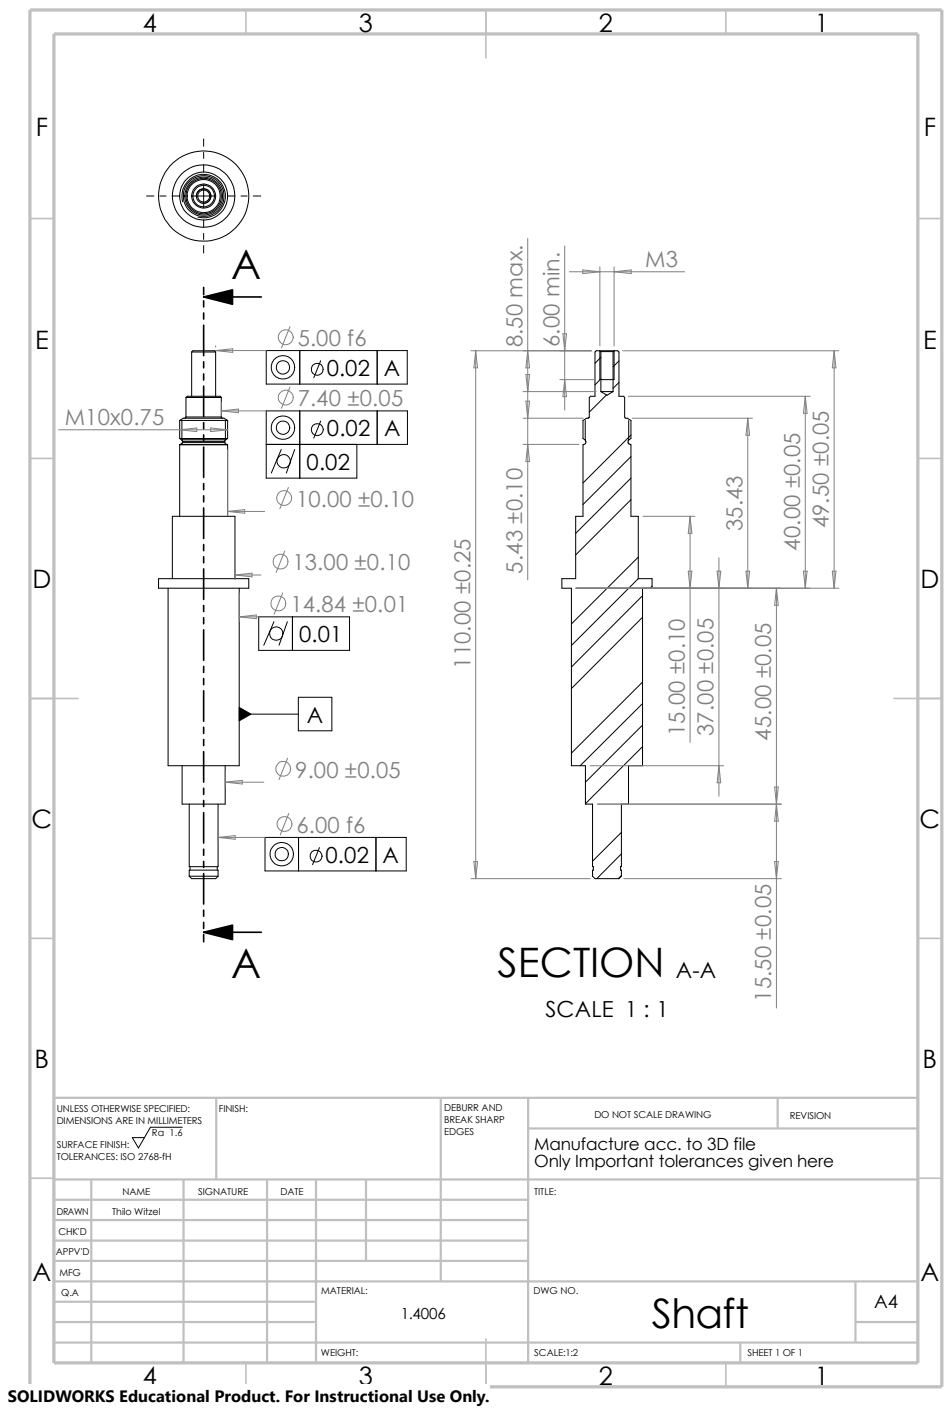
[picture p33: page 1]
FINISH:; BREAK SHARP; SCALE:1:2; DWG NO.; REVISION; SHEET 1 OF 1; WEIGHT:; MFG; EDGES; MATERIAL:; DEBURR AND; Shaft; A SECTION A-A; SCALE 1 : 1; 45.00 ±0.05 15.50 ±0.05 8.50 max.; 49.50 ±0.05 6.00 min. 5.43 ±0.10 110.00 ±0.25

0.02 | A
0.02

UNLESS OTHERWISE SPECIFIED:
DIMENSIONS ARE IN MILLIMETERS

DO NOT SCALE DRAWING
Manufacture acc. to 3D file
Only Important tolerances given here

SURFACE FINISH:
TOLERANCES: ISO 2768-fH

NAME | SIGNATURE | DATE | TITLE:

DRAWN | Thilo Witzel
CHK'D
APPV'D

SOLIDWORKS Educational Product. For Instructional Use Only.
