TheWisator/RPII_DC_ePump/Submission/04_Drawings/02_Pump/LOX_Pump_Impeller_Diffuser.pdf

E | E
F | F

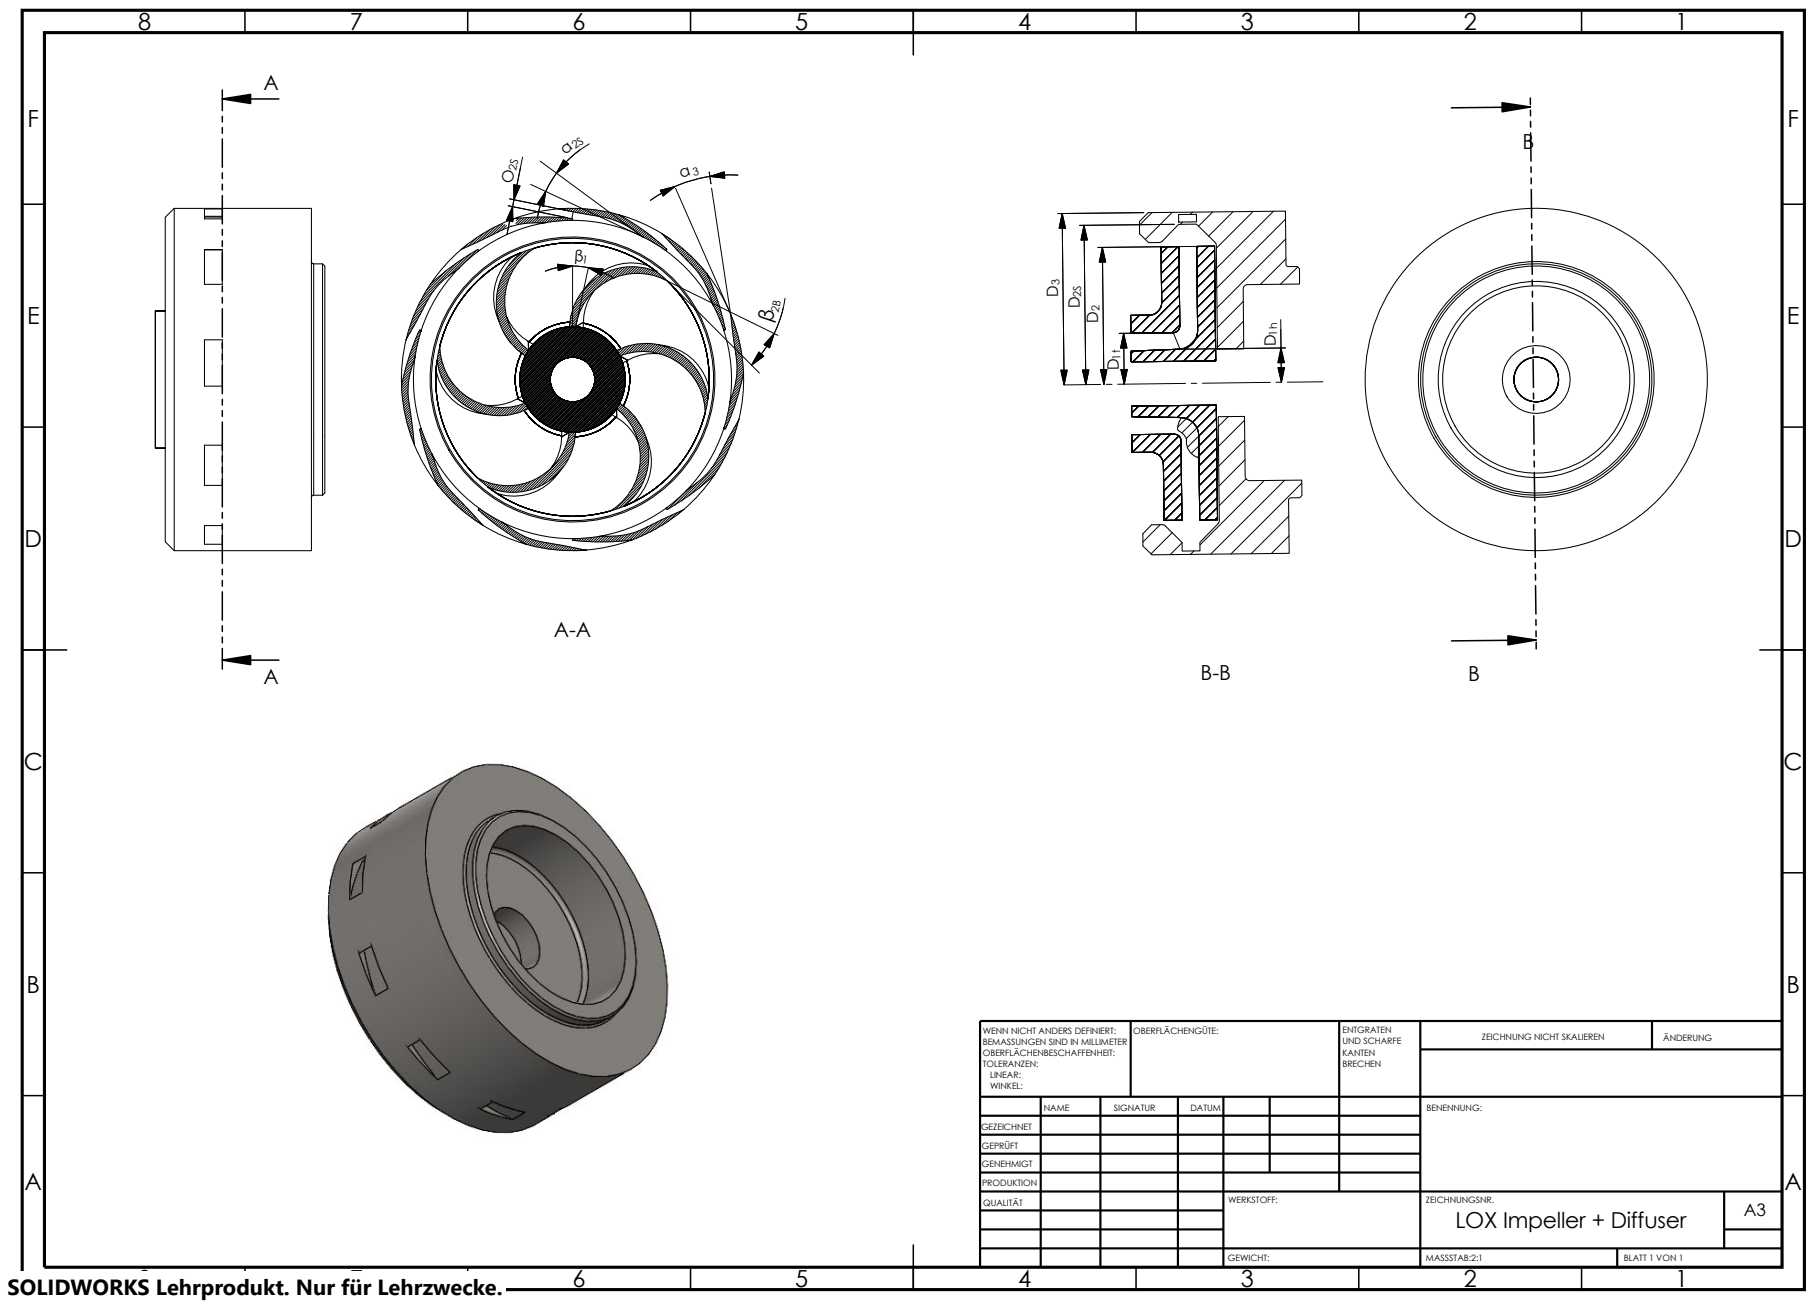
[picture p34: page 1]
NAME; ENTGRATEN; KANTEN; UND SCHARFE; BRECHEN; OBERFLÄCHENGÜTE:; WINKEL:; BLATT 1 VON 1; SIGNATUR; DATUM; WERKSTOFF:; BENENNUNG:; ÄNDERUNG; MASSSTAB:2:1; GEWICHT:; OBERFLÄCHENBESCHAFFENHEIT: TOLERANZEN: LINEAR:

ZEICHNUNG NICHT SKALIEREN WENN NICHT ANDERS DEFINIERT: BEMASSUNGEN SIND IN MILLIMETER

GEZEICHNET
GEPRÜFT
GENEHMIGT
PRODUKTION QUALITÄT

ZEICHNUNGSNR.
A3 LOX Impeller + Diffuser

SOLIDWORKS Lehrprodukt. Nur für Lehrzwecke.
