TheWisator/RPII_DC_ePump/Submission/01_Skripts/02_Motor/FEM Studies/EM/Eff_Map.pdf

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

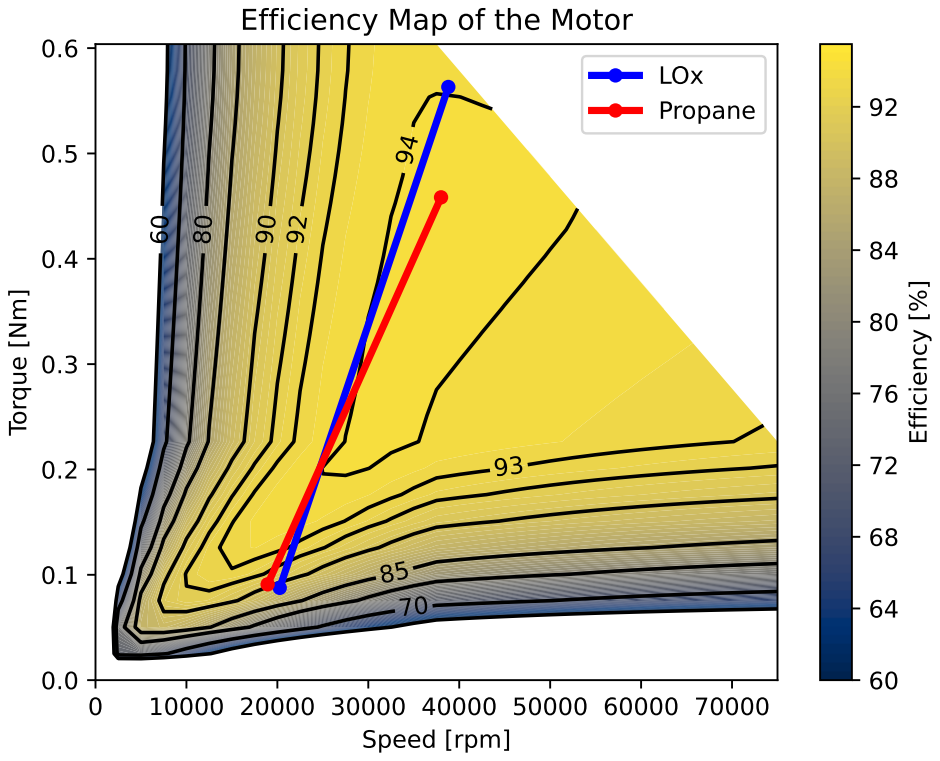
[picture p35: page 1]
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
