TheWisator/RPII_DC_ePump/(commit log)

2024-03-20 Motor FEM Studies
    [Optim_Results_1.csv, Optim_Results_1.xlsx]
2024-03-20 Pump optimization scripts
2024-03-20 Battery design
2024-03-20 Updated Submission Documents
    [12x21x5-Ang_Hybrid_Ball_Bearing.SLDPRT, 65363000-KM 0-M10 x 0_75.stp, 65399530-MB 0.stp, 7x14x5-Hybrid_Ball_Bearing.SLDPRT, Battery.stp, Bearing-Ring.SLDPRT, CFRP-Rotor-Sleeve.SLDPRT, CI20-239-C-Ring.SLDPRT]
